mauriciobarroso/planther_pcb/planter_pcb.kicad_pcb

## KiCad design planter_pcb.kicad_pcb (2026-05-15)

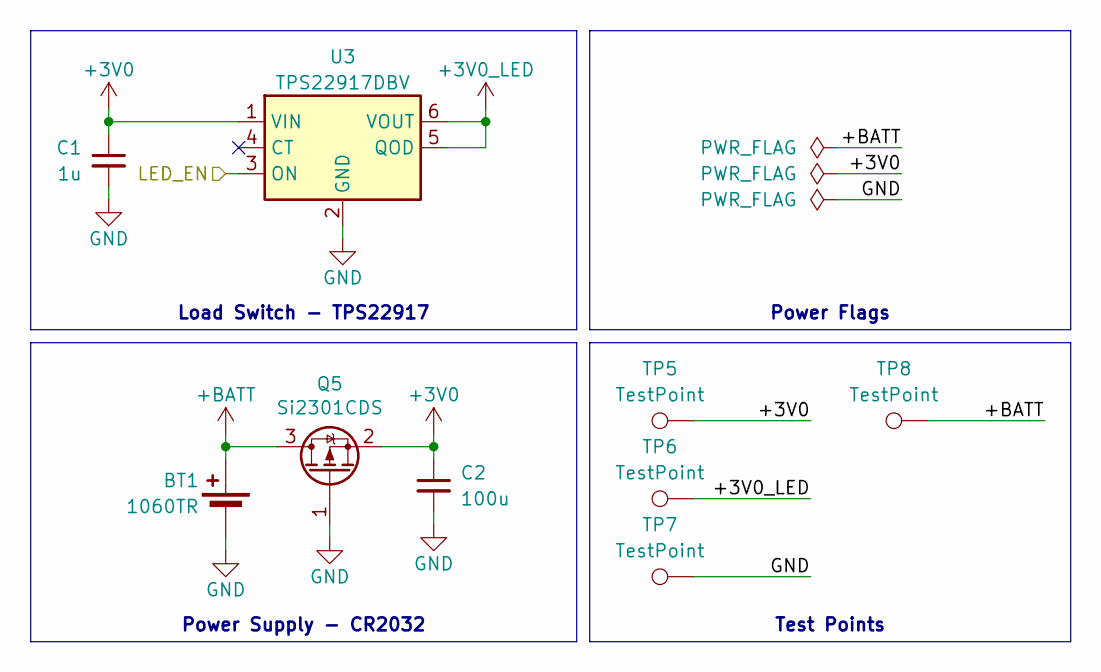
[picture p1: schematic power.kicad_sch, PlanTher]

Parts:
BT1: 1060TR; BatteryHolder_Keystone_1060_1x2032; LCSC C238069
C1: 1u; C_0603_1608Metric; LCSC C15849
C2: 100u; C_1206_3216Metric; LCSC C15008
Q5: Si2301CDS; SOT-23; LCSC C10487
TP5, TP6, TP7, TP8: TestPoint; TestPoint_Pad_D1.0mm
U3: TPS22917DBV; SOT-23-6; LCSC C2681320

Connections:
+3V0: C1.1, C2.1, Q5.2 (S), TP5.1, U3.1 (VIN); also elsewhere on the board
+3V0_LED: TP6.1, U3.5 (QOD), U3.6 (VOUT); also elsewhere on the board
+BATT: BT1.1 (+), Q5.3 (D), TP8.1
/MCU/LED_EN: U3.3 (ON); also elsewhere on the board
GND: BT1.2 (-), C1.2, C2.2, Q5.1 (G), TP7.1, U3.2 (GND); also elsewhere on the board

Notes on the sheet:
Power Flags
Power Supply - CR2032
Test Points
Load Switch - TPS22917

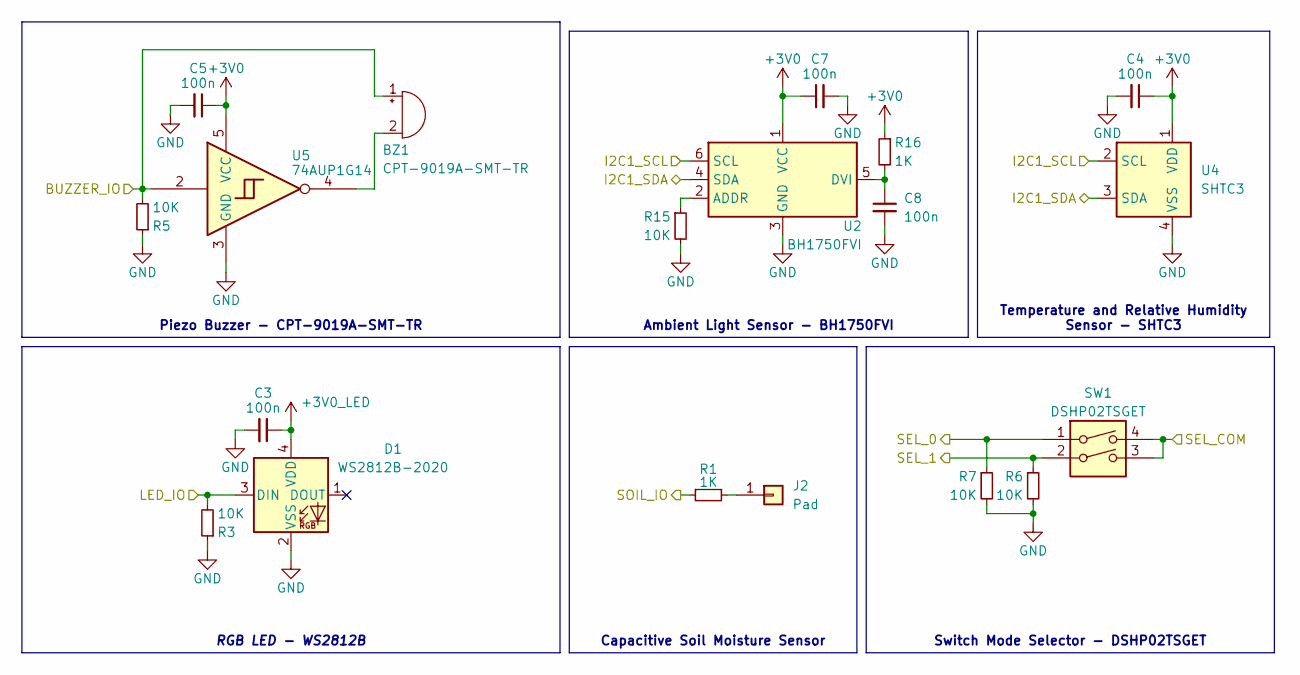
[picture p2: schematic peripherals.kicad_sch, PlanTher]

Parts:
BZ1: CPT-9019A-SMT-TR; Buzzer_CUI_CPT-9019S-SMT; LCSC C20181991
C3, C4, C5, C7, C8: 100n; C_0603_1608Metric; LCSC C14663
D1: WS2812B-2020; LED_WS2812B-2020_PLCC4_2.0x2.0mm; LCSC C965555
J2: Pad; SoilMoisture_Pad
R1, R16: 1K; R_0603_1608Metric; LCSC C21190
R3, R5, R6, R7, R15: 10K; R_0603_1608Metric; LCSC C25804
SW1: DSHP02TSGET; SW_DIP_SPSTx02_Slide_KingTek_DSHP02TS_W7.62mm_P1.27mm; LCSC C40735
U2: BH1750FVI; LCSC C78960
U4: SHTC3; Sensirion_DFN-4-1EP_2x2mm_P1mm_EP0.7x1.6mm; LCSC C2880044
U5: 74AUP1G14; SOT-23-5; LCSC C2682131

Connections:
+3V0: C4.1, C5.1, C7.1, R16.1, U2.1 (VCC), U4.1 (VDD), U5.5 (VCC); also elsewhere on the board
+3V0_LED: C3.1, D1.4 (VDD); also elsewhere on the board
/MCU/BUZZER_IO: BZ1.1 (+), R5.2, U5.2; also elsewhere on the board
/MCU/I2C1_SCL: U2.6 (SCL), U4.2 (SCL); also elsewhere on the board
/MCU/I2C1_SDA: U2.4 (SDA), U4.3 (SDA); also elsewhere on the board
/MCU/LED_IO: D1.3 (DIN), R3.2; also elsewhere on the board
/MCU/SEL_0: R7.1, SW1.1; also elsewhere on the board
/MCU/SEL_1: R6.1, SW1.2; also elsewhere on the board
/MCU/SEL_COM: SW1.3, SW1.4; also elsewhere on the board
/MCU/SOIL_IO: R1.1; also elsewhere on the board
GND: C3.2, C4.2, C5.2, C7.2, C8.2, D1.2 (VSS), R3.1, R5.1, R6.2, R7.2, R15.2, U2.3 (GND), U4.4 (VSS), U5.3 (GND); also elsewhere on the board
unnamed: BZ1.2 (-), U5.4
unnamed: J2.1, R1.2
unnamed: R15.1, U2.2 (ADDR)
unnamed: C8.1, R16.2, U2.5 (DVI)

Notes on the sheet:
RGB LED - WS2812B
Ambient Light Sensor - BH1750FVI
Temperature and Relative Humidity Sensor - SHTC3
Piezo Buzzer - CPT-9019A-SMT-TR
Switch Mode Selector - DSHP02TSGET
Capacitive Soil Moisture Sensor

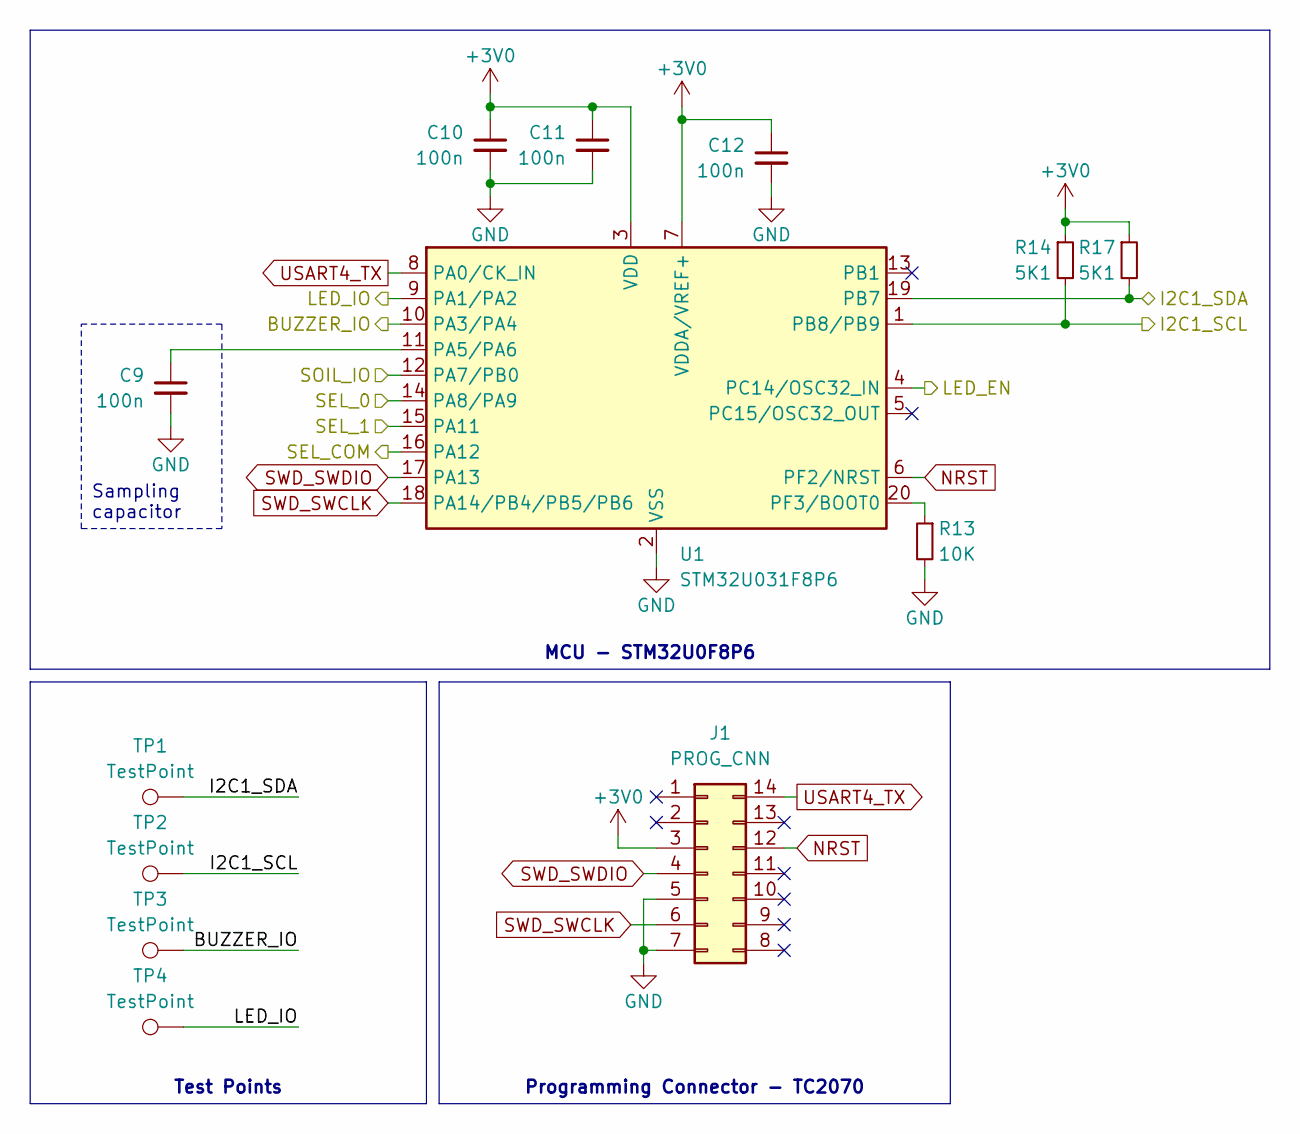
[picture p3: schematic mcu.kicad_sch, PlanTher]

Parts:
C9, C10, C11, C12: 100n; C_0603_1608Metric; LCSC C14663
J1: PROG_CNN; Tag-Connect_TC2070-IDC-FP_2x07_P1.27mm_Vertical
R13: 10K; R_0603_1608Metric; LCSC C25804
R14, R17: 5K1; R_0603_1608Metric; LCSC C23186
TP1, TP2, TP3, TP4: TestPoint; TestPoint_Pad_D1.0mm
U1: STM32U031F8P6; TSSOP-20_4.4x6.5mm_P0.65mm; LCSC C22808553

Connections:
+3V0: C10.1, C11.1, C12.1, J1.3, R14.1, R17.1, U1.3 (VDD), U1.7 (VDDA/VREF+); also elsewhere on the board
/MCU/BUZZER_IO: TP3.1, U1.10 (PA3/PA4); also elsewhere on the board
/MCU/I2C1_SCL: R14.2, TP2.1, U1.1 (PB8/PB9); also elsewhere on the board
/MCU/I2C1_SDA: R17.2, TP1.1, U1.19 (PB7); also elsewhere on the board
/MCU/LED_EN: U1.4 (PC14/OSC32_IN); also elsewhere on the board
/MCU/LED_IO: TP4.1, U1.9 (PA1/PA2); also elsewhere on the board
/MCU/SEL_0: U1.14 (PA8/PA9); also elsewhere on the board
/MCU/SEL_1: U1.15 (PA11); also elsewhere on the board
/MCU/SEL_COM: U1.16 (PA12); also elsewhere on the board
/MCU/SOIL_IO: U1.12 (PA7/PB0); also elsewhere on the board
GND: C9.2, C10.2, C11.2, C12.2, J1.5, J1.7, R13.2, U1.2 (VSS); also elsewhere on the board
NRST: J1.12, U1.6 (PF2/NRST)
unnamed: C9.1, U1.11 (PA5/PA6)
unnamed: R13.1, U1.20 (PF3/BOOT0)
SWD_SWCLK: J1.6, U1.18 (PA14/PB4/PB5/PB6)
SWD_SWDIO: J1.4, U1.17 (PA13)
USART4_TX: J1.14, U1.8 (PA0/CK_IN)

Notes on the sheet:
MCU - STM32U0F8P6
Test Points
Programming Connector - TC2070
Sampling capacitor

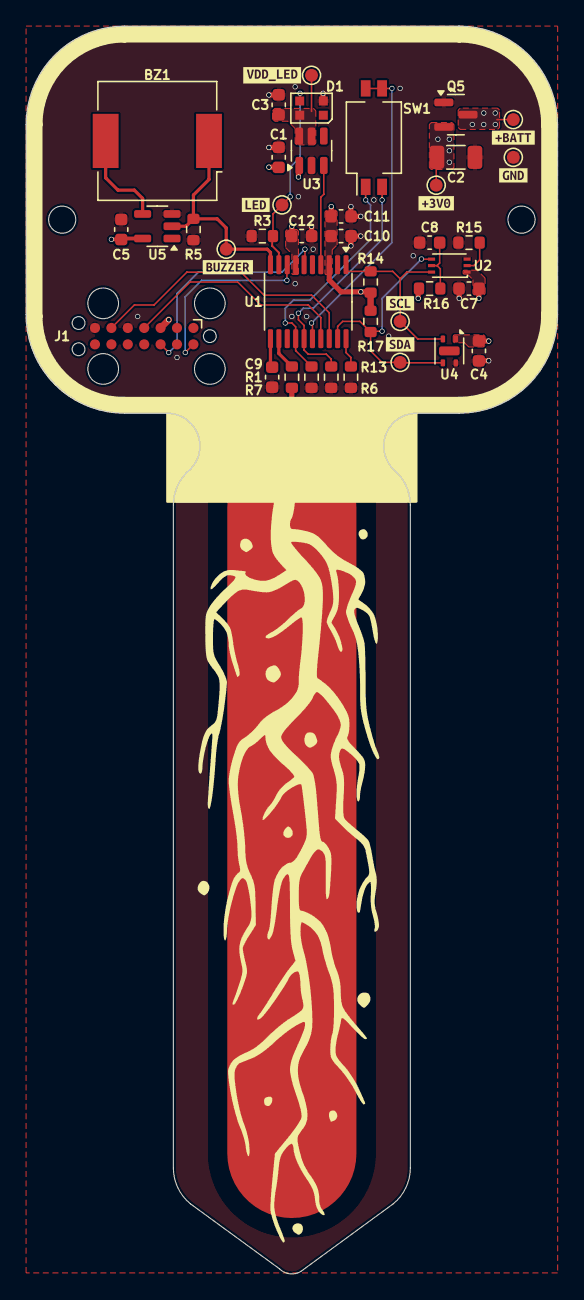
[picture p4: board planter_pcb.kicad_pcb from above]

Board: 4 copper layers, 41.1 x 96.6 mm, 49 parts (1 on the bottom side), 23 nets.

Other parts of the board:
kibuzzard-6805202F: G***; kibuzzard-6805202F
kibuzzard-6805203A: G***; kibuzzard-6805203A
kibuzzard-6805205E: G***; kibuzzard-6805205E
kibuzzard-68052017: G***; kibuzzard-68052017
kibuzzard-68052025: G***; kibuzzard-68052025
kibuzzard-68052045: G***; kibuzzard-68052045
kibuzzard-68052051: G***; kibuzzard-68052051
kibuzzard-68052059: G***; kibuzzard-68052059
