mauriciobarroso/planther_pcb/(commit log)

2025-04-23 added schematics
    [alarms.kicad_sch, mcu.kicad_sch, power.kicad_sch, sensors.kicad_sch]
2025-04-23 added main schematic
    [planter_pcb.kicad_sch]
2025-04-23 added pcb layout
    [planter_pcb.kicad_pcb]
2025-04-23 added kicad project file
2026-05-15 updated last changes
    [alarms.kicad_sch, mcu.kicad_sch, peripherals.kicad_sch, planter_pcb.kicad_pcb, planter_pcb.kicad_sch, power.kicad_sch, sensors.kicad_sch]
